ChristmasOrnaments/2025-Mouse/pcb/2025_Mouse.kicad_sch

## KiCad design pcb/2025_Mouse.kicad_sch (2026-03-22)

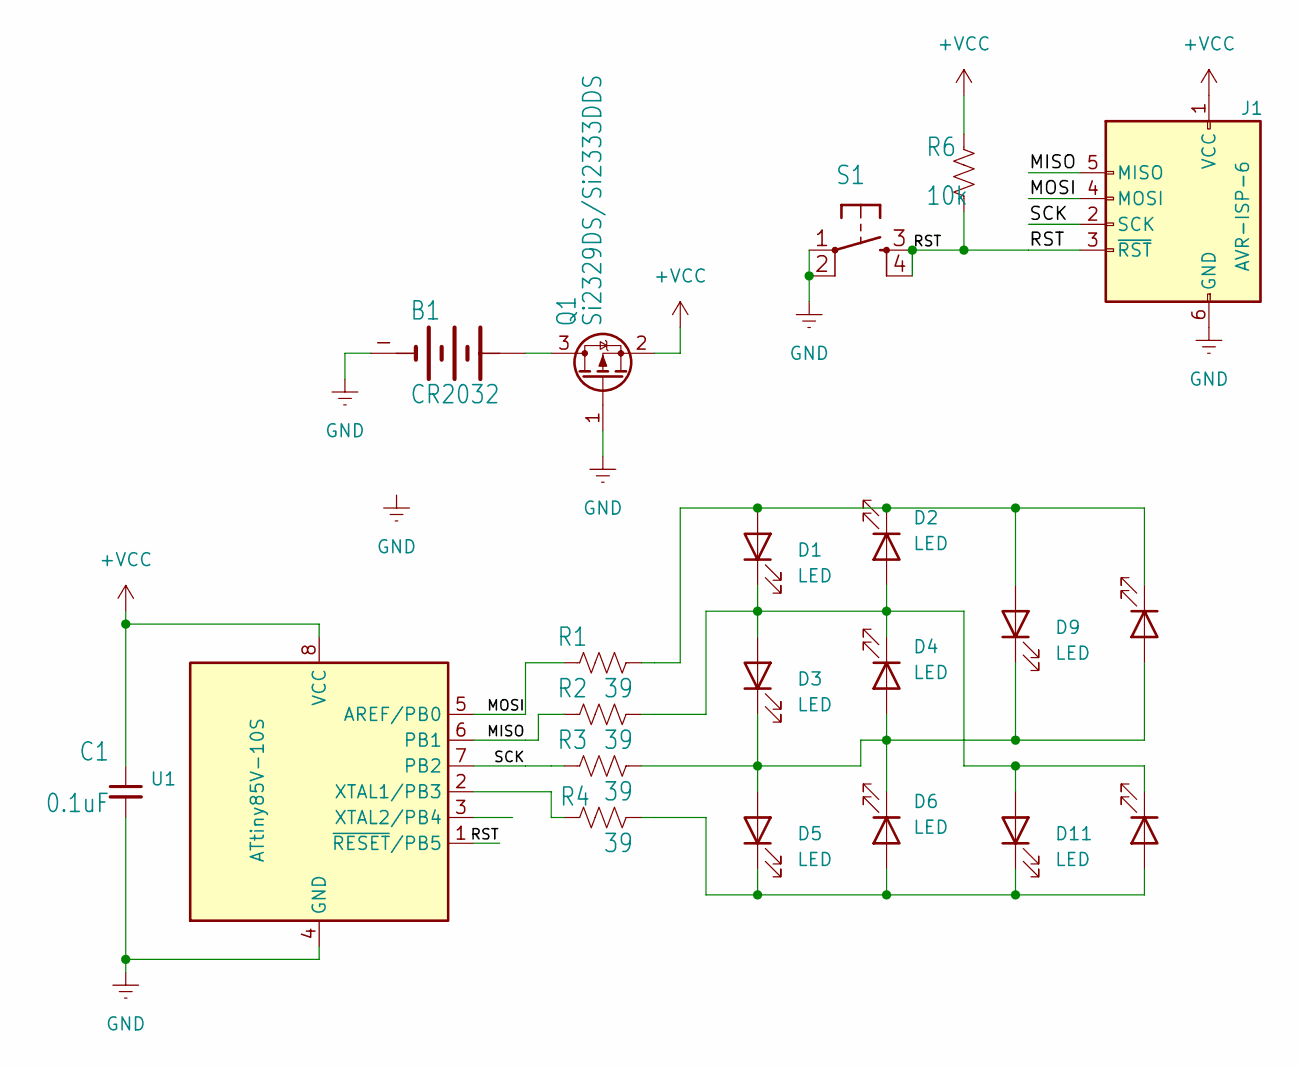
[picture p4: schematic 2025_Mouse.kicad_sch]

Parts:
B1: CR2032; BAT-HLD-001
C1: 0.1uF; C_0805_2012Metric
D1, D2, D3, D4, D5, D6, D9, D10, D11, D12: LED; LED_0805_2012Metric
J1: AVR-ISP-6; AVR_ICSP_1X6_SMD
Q1: Si2329DS/Si2333DDS; SOT-23
R1, R2, R3, R4: 39; R_0805_2012Metric
R6: 10k; R_0805_2012Metric
S1: TACTILE_SWITCH_SMD
U1: ATtiny85V-10S; SOIC-8_5.3x5.3mm_P1.27mm

Connections:
+VCC: C1.1, J1.1 (VCC), Q1.2 (S), R6.1, U1.8 (VCC)
GND: B1.-, C1.2, J1.6 (GND), Q1.1 (G), S1.1, S1.2, U1.4 (GND)
MISO: J1.5 (MISO), R2.2, U1.6 (PB1)
MOSI: J1.4 (MOSI), R1.2, U1.5 (AREF/PB0)
unnamed: B1.+@1, B1.+@2, Q1.3 (D)
unnamed: D1.1 (K), D2.2 (A), D3.2 (A), D4.1 (K), D11.2 (A), D12.1 (K), R2.1
unnamed: D1.2 (A), D2.1 (K), D9.2 (A), D10.1 (K), R1.1
unnamed: D3.1 (K), D4.2 (A), D5.2 (A), D6.1 (K), D9.1 (K), D10.2 (A), R3.1
unnamed: D5.1 (K), D6.2 (A), D11.1 (K), D12.2 (A), R4.1
unnamed: R4.2, U1.2 (XTAL1/PB3)
RST: J1.3 (~RST), R6.2, S1.3, S1.4, U1.1 (~RESET/PB5)
SCK: J1.2 (SCK), R3.2, U1.7 (PB2)
